ConnexPCB/pcb_piano/README.md

# pcb_piano
PCB with cap touch buttons that activate frequency generator
