ConnexPCB/pcb_piano/pcb_piano/pcb_piano_v1.pdf

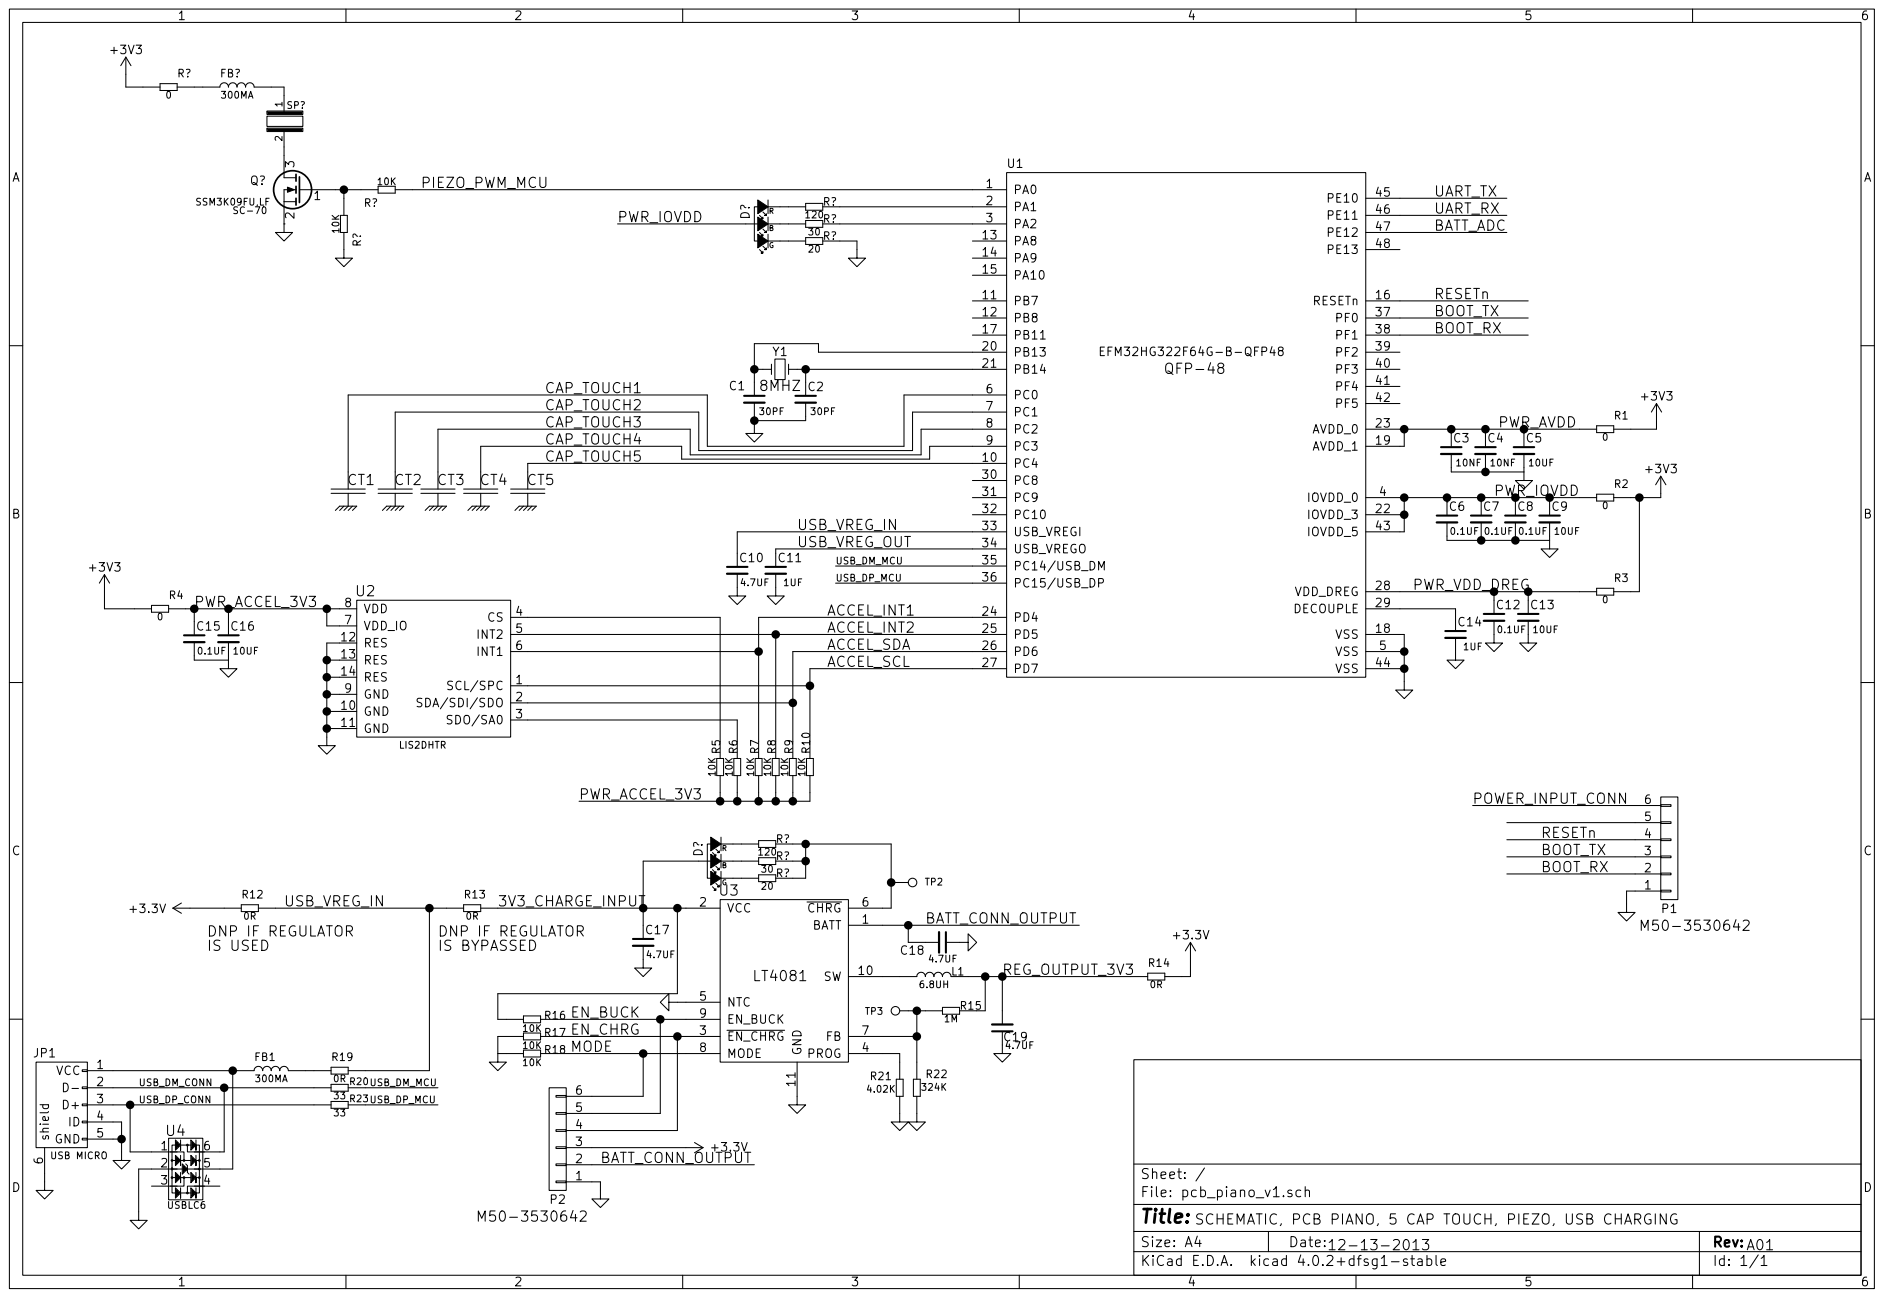
[picture p1: page 1]

CAP_TOUCH2
CAP_TOUCH3
CAP_TOUCH4
CAP_TOUCH5

SCHEMATIC, PCB PIANO, 5 CAP TOUCH, PIEZO, USB CHARGING
