ConnexPCB/pcb_piano/pcb_piano/pcb_piano_v1.kicad_pcb

## KiCad design pcb_piano/pcb_piano_v1.kicad_pcb (2017-12-29)

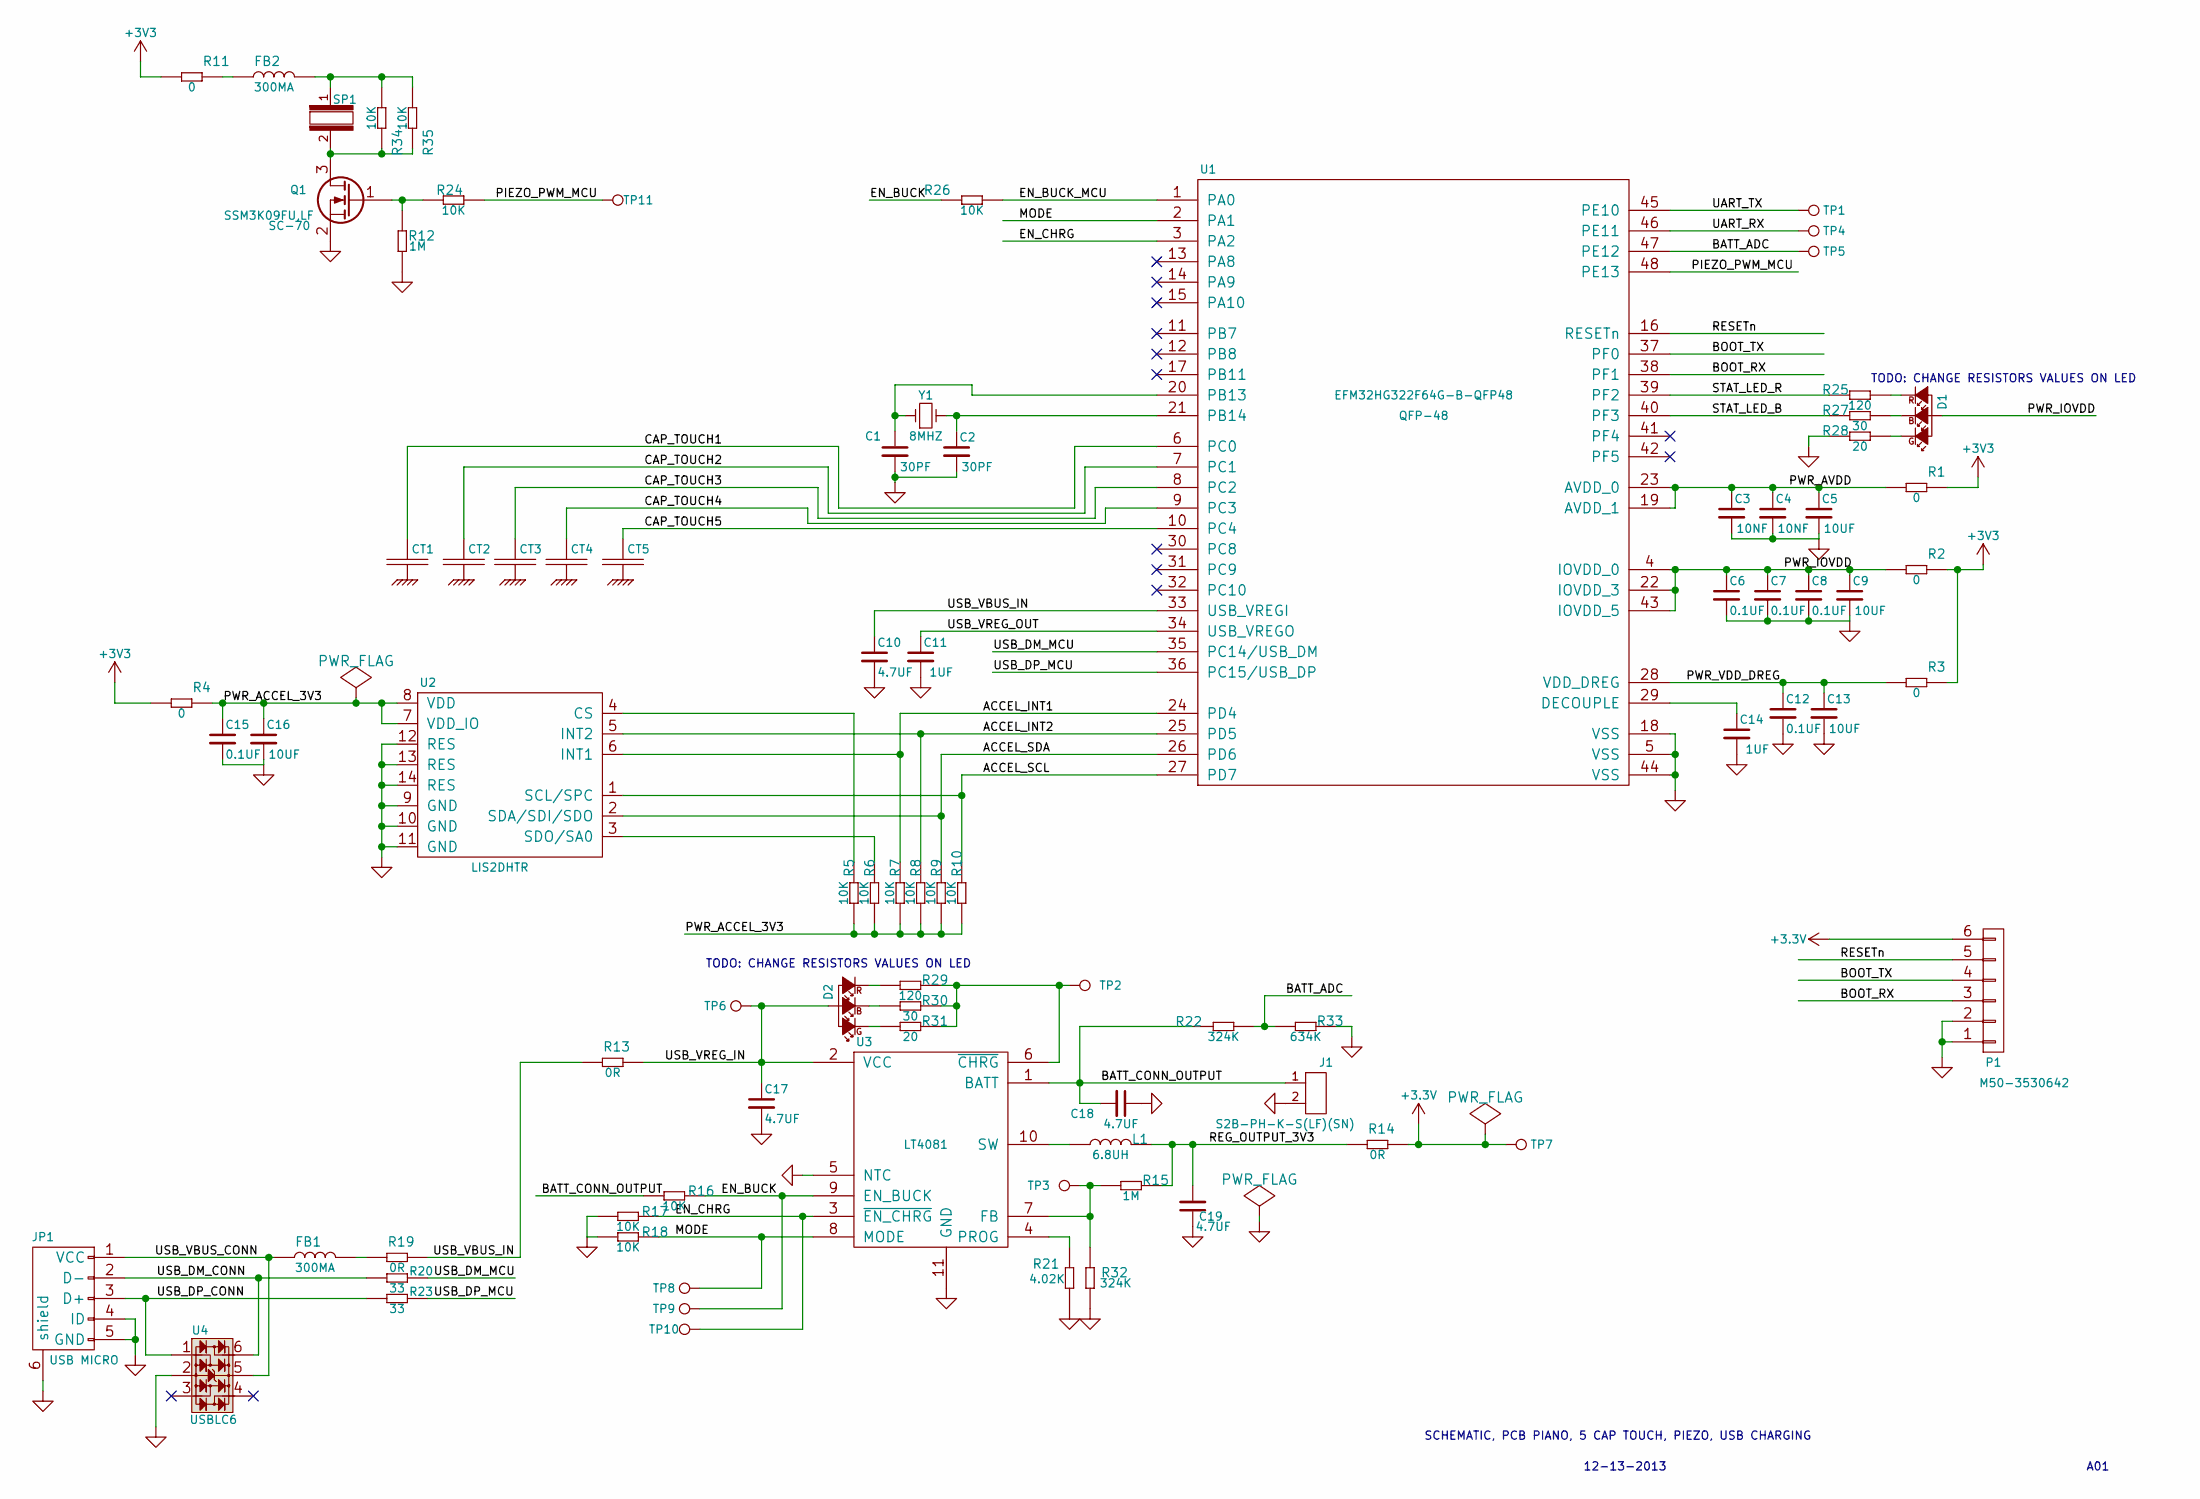
[picture p2: schematic pcb_piano_v1.sch]

Parts:
C1, C2: CONNEX-SMD-CAP-30PF-0402; C_0402; VOLTAGE 25V; MPN GRM1555C1E300JA01D
C3, C4: CONNEX-SMD-CAP-10NF-0402; C_0402; MPN GRM155R71C103KA01D
C5, C9, C13, C16: CONNEX-SMD-CAP-10UF-0402; C_0402; VOLTAGE 6.3V; MPN GRJ155R60J106ME11D
C6, C7, C8, C12, C15: CONNEX-SMD-CAP-100NF-0402; C_0402; MPN GRM155R71E104KE14D
C10, C17, C18, C19: CONNEX-SMD-CAP-4700NF-0603; C_0603; MPN GRM188R60J475ME19D
C11, C14: CONNEX-SMD-CAP-1UF-0402; C_0402; VOLTAGE 35V; MPN GRM155R6YA105KE11J
CT1, CT2, CT3, CT4, CT5: CONNEX-CAPTOUCH-BUTTON-SINGLE; CONNEX-CAPTOUCH-SINGLE-BUTTON-15MM; MPN NA
D1, D2: LED_RGB_SMLP34RGB1W3; led_0404_SMLP34RGB1W3; MPN SMLP34RGB1W3
FB1, FB2: CONNEX-SMD-FERRITE-BEAD-300MA-BLM15AG102SN1D; L_0402; MPN BLM15AG102SN1D
J1: CONNEX_CONN_2PIN_KEYED; CONNEX_CONN-2POS-KEYED-S2B-PH-K-S; MPN S2B-PH-K-S(LF)(SN)
JP1: connex_usb_micro_b_10103594-0001LF; USB_Micro-B_10103594-0001LF; MPN 10118194-0001LF
L1: CONNEX-SMD-INDUCTOR-6R8M-0603; L_0603; MPN GLFR1608T6R8M-LR
P1: CONN_01X06_M50-3530642; Pin_Header_Straight_1x06; MPN M50-3530642
Q1: Q_NMOS_SSM3K09FULF; SC-70; MPN SSM3K09FU,LF
R1, R2, R3, R4, R11: CONNEX-SMD-RES-0-0603; R_0603; MPN CRCW06030000Z0EAHP
R5, R6, R7, R8, R9, R10, R24, R34, R35: CONNEX-SMD-RES-10K-0603; R_0603; MPN CRCW060310K0FKEAHP
R12, R15: CONNEX-SMD-RES-1M-0603; R_0603; MPN RCG06031M00FKEA
R13, R14, R19: SMD-RES-0R-1_4W_0603_; R_0603; MPN CRCW06030000Z0EAHP
R16, R17, R18, R26: SMD-RES-10K-1%-1_10W_0603_; R_0603
R20, R23: CONNEX-SMD-RES-33-0402; R_0402; MPN ERJ-2RKF33R0X
R21: CONNEX-SMD-RES-4K02-0603; R_0603; MPN CRCW06034K02FKEA
R22, R32: CONNEX-SMD-RES-324K-0402; R_0402; MPN RC0402FR-07324KL
R25, R29: CONNEX-SMD-RES-120-0603; R_0603; MPN CRCW0603120RJNEA
R27, R30: CONNEX-SMD-RES-30-0603; R_0603; MPN CRCW060330R0JNEA
R28, R31: CONNEX-SMD-RES-20-0603; R_0603; MPN CRCW060320R0JNEA
R33: CONNEX-SMD-RES-634k-0402; R_0402; MPN ERJ-2RKF6343X
SP1: connex-piezo-4khz-AT-2440-TWT-R; CONNEX-PIEZO-AT-2440-TWT-R; MPN AT-2440-TWT-R
TP1, TP2, TP3, TP4, TP5, TP6, TP7, TP8, TP9, TP10, TP11: test_point_smt; TEST_POINT_SMD_50MIL; MPN na
U1: connex_EFM32HG322F64G-B-QFP48; TQFP-48_7x7mm_Pitch0.5mm; MPN EFM32HG322F64G-B-QFP48
U2: connex-accel-LIS2DHTR; CONNEX_LGA-14_2MMX2MM; MPN LIS2DHTR
U3: CONNEX_REGUL_LT4081; CONNEX_DFN_10PIN_3MMX3MM; MPN LTC4081EDD#PBF
U4: CONNEX-DIODE-TVS-USB-USBLC6-4SC6Y; SOT-23-6; MPN USBLC6-4SC6Y
Y1: Crystal_8MHZ_ABM3B-8.000MHZ-B2-T; CONNEX_CRYSTAL_4SMD_32X50; MPN ABM3B-8.000MHZ-B2-T

Connections:
/ACCEL_INT1: R7.2, U1.24 (PD4), U2.6 (INT1)
/ACCEL_INT2: R8.2, U1.25 (PD5), U2.5 (INT2)
/ACCEL_SCL: R10.2, U1.27 (PD7), U2.1 (SCL/SPC)
/ACCEL_SDA: R9.2, U1.26 (PD6), U2.2 (SDA/SDI/SDO)
/BATT_ADC: R22.1, R33.1, TP5.1, U1.47 (PE12)
/BATT_CONN_OUTPUT: C18.2, J1.1, R16.2, R22.2, U3.1 (BATT)
/BOOT_RX: P1.3, U1.38 (PF1)
/BOOT_TX: P1.4, U1.37 (PF0)
/CAP_TOUCH1: CT1.1, U1.6 (PC0)
/CAP_TOUCH2: CT2.1, U1.7 (PC1)
/CAP_TOUCH3: CT3.1, U1.8 (PC2)
/CAP_TOUCH4: CT4.1, U1.9 (PC3)
/CAP_TOUCH5: CT5.1, U1.10 (PC4)
/EN_BUCK: R16.1, R26.2, TP9.1, U3.9 (EN_BUCK)
/EN_BUCK_MCU: R26.1, U1.1 (PA0)
/EN_CHRG: R17.1, TP10.1, U1.3 (PA2), U3.3 (~EN_CHRG~)
/MODE: R18.1, TP8.1, U1.2 (PA1), U3.8 (MODE)
/PIEZO_PWM_MCU: R24.1, TP11.1, U1.48 (PE13)
/PWR_ACCEL_3V3: C15.1, C16.1, R4.2, R5.1, R6.1, R7.1, R8.1, R9.1, R10.1, U2.7 (VDD_IO), U2.8 (VDD)
/PWR_AVDD: C3.1, C4.1, C5.1, R1.1, U1.19 (AVDD_1), U1.23 (AVDD_0)
/PWR_IOVDD: C6.1, C7.1, C8.1, C9.1, D1.1, R2.1, U1.4 (IOVDD_0), U1.22 (IOVDD_3), U1.43 (IOVDD_5)
/PWR_VDD_DREG: C12.1, C13.1, R3.1, U1.28 (VDD_DREG)
/REG_OUTPUT_3V3: C19.2, L1.2, R14.1, R15.2
/RESETn: P1.5, U1.16 (RESETn)
/STAT_LED_B: R27.2, U1.40 (PF3)
/STAT_LED_R: R25.2, U1.39 (PF2)
/UART_RX: TP4.1, U1.46 (PE11)
/UART_TX: TP1.1, U1.45 (PE10)
/USB_DM_CONN: JP1.2 (D-), R20.1, U4.6 (IO4)
/USB_DM_MCU: R20.2, U1.35 (PC14/USB_DM)
/USB_DP_CONN: JP1.3 (D+), R23.1, U4.1 (IO1)
/USB_DP_MCU: R23.2, U1.36 (PC15/USB_DP)
/USB_VBUS_CONN: FB1.1, JP1.1 (VCC), U4.5 (VBUS)
/USB_VBUS_IN: C10.1, R13.1, R19.2, U1.33 (USB_VREGI)
/USB_VREG_IN: C17.1, D2.1, R13.2, TP6.1, U3.2 (VCC)
/USB_VREG_OUT: C11.1, U1.34 (USB_VREGO)
GND: C1.2, C2.2, C3.2, C4.2, C5.2, C6.2, C7.2, C8.2, C9.2, C10.2, C11.2, C12.2, C13.2, C14.2, C15.2, C16.2, C17.2, C18.1, C19.1, J1.2, JP1.4 (ID), JP1.5 (GND), JP1.6 (shield), P1.1, P1.2, Q1.2 (S), R12.2, R17.2, R18.2, R21.1, R28.2, R32.2, R33.2, U1.5 (VSS), U1.18 (VSS), U1.44 (VSS), U2.9 (GND), U2.10 (GND), U2.11 (GND), U2.12 (RES), U2.13 (RES), U2.14 (RES), U3.5 (NTC), U3.11 (GND), U4.2 (GND)
unnamed: C1.1, U1.20 (PB13), Y1.1
unnamed: C2.1, U1.21 (PB14), Y1.3
unnamed: C14.1, U1.29 (DECOUPLE)
unnamed: D1.2 (R), R25.1
unnamed: D1.3 (B), R27.1
unnamed: D1.4 (G), R28.1
unnamed: D2.2 (R), R29.1
unnamed: D2.3 (B), R30.1
unnamed: D2.4 (G), R31.1
unnamed: FB1.2, R19.1
unnamed: FB2.1, R11.2
unnamed: FB2.2, R34.1, R35.1, SP1.1
unnamed: L1.1, U3.10 (SW)
unnamed: Q1.1 (G), R12.1, R24.2
unnamed: Q1.3 (D), R34.2, R35.2, SP1.2
unnamed: R5.2, U2.4 (CS)
unnamed: R6.2, U2.3 (SDO/SA0)
unnamed: R15.1, R32.1, TP3.1, U3.7 (FB)
unnamed: R21.2, U3.4 (PROG)
unnamed: R29.2, R30.2, R31.2, TP2.1, U3.6 (~CHRG~)

Notes on the sheet:
SCHEMATIC, PCB PIANO, 5 CAP TOUCH, PIEZO, USB CHARGING
12-13-2013
A01
TODO: CHANGE RESISTORS VALUES ON LED

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
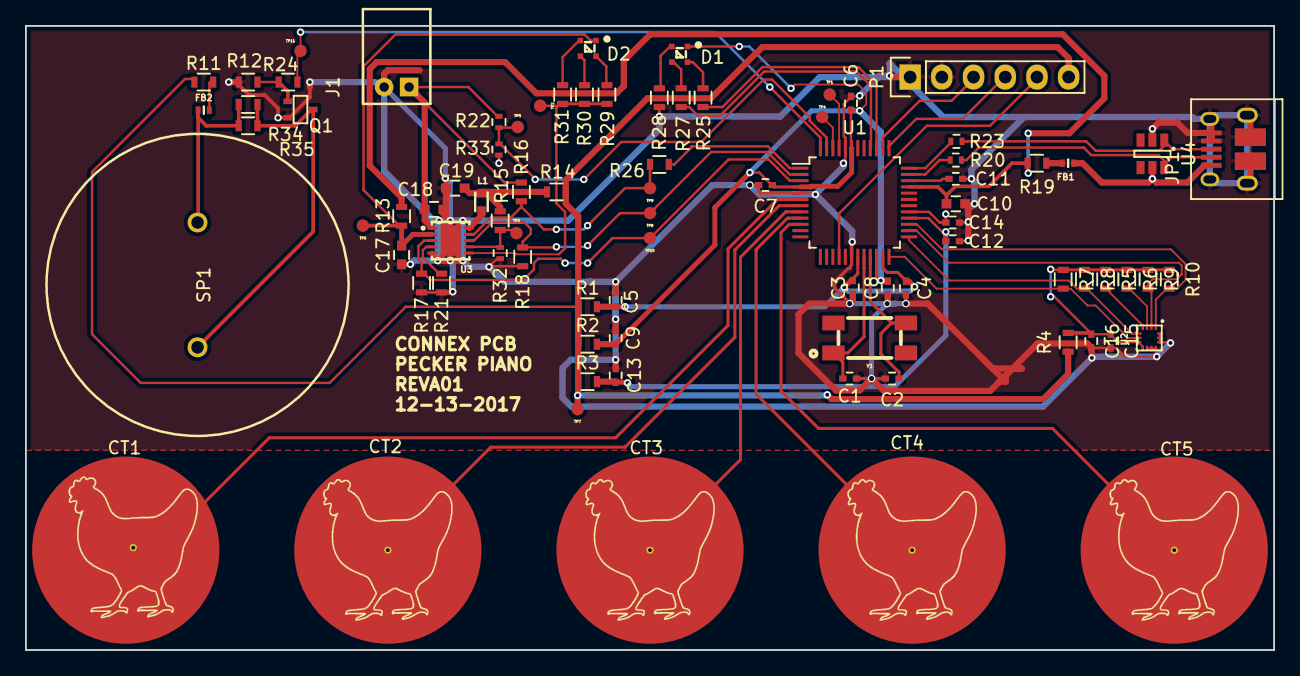
[picture p3: board pcb_piano_v1.kicad_pcb from above]

Board: 2 copper layers, 100.0 x 50.0 mm, 85 parts (0 on the bottom side), 58 nets.
