ConnexPCB/pcb_piano/sw_piano/testFirmware/src/sinTable.cpp

/*
 * sinTable.c
 *
 *  Created on: Jan 2, 2018
 *      Author: birdman
 */

#include "sinTable.h"


 static const uint32_t sineTableLength = NUM_SINE_SAMPLES;
//  static const uint16_t sineTable[NUM_SINE_SAMPLES] =
//  {
// 375,	375,	376,	376,	377,	377,	378,	379,	379,	380,	380,	381,	381,	382,	383,	383,	384,	384,	385,	385,	386,	387,	387,	388,	388,	389,	389,	390,	391,	391,	392,	392,
// 393,	393,	394,	395,	395,	396,	396,	397,	397,	398,	399,	399,	400,	400,	401,	402,	402,	403,	403,	404,	404,	405,	406,	406,	407,	407,	408,	408,	409,	410,	410,	411,
// 411,	412,	412,	413,	414,	414,	415,	415,	416,	416,	417,	418,	418,	419,	419,	420,	420,	421,	422,	422,	423,	423,	424,	424,	425,	426,	426,	427,	427,	428,	428,	429,
// 430,	430,	431,	431,	432,	432,	433,	434,	434,	435,	435,	436,	436,	437,	437,	438,	439,	439,	440,	440,	441,	441,	442,	443,	443,	444,	444,	445,	445,	446,	447,	447,
// 448,	448,	449,	449,	450,	450,	451,	452,	452,	453,	453,	454,	454,	455,	456,	456,	457,	457,	458,	458,	459,	459,	460,	461,	461,	462,	462,	463,	463,	464,	465,	465,
// 466,	466,	467,	467,	468,	468,	469,	470,	470,	471,	471,	472,	472,	473,	473,	474,	475,	475,	476,	476,	477,	477,	478,	478,	479,	479,	480,	481,	481,	482,	482,	483,
// 483,	484,	484,	485,	486,	486,	487,	487,	488,	488,	489,	489,	490,	490,	491,	492,	492,	493,	493,	494,	494,	495,	495,	496,	496,	497,	498,	498,	499,	499,	500,	500,
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
//		134,	134,	134,	134,	134,	134,	134,	134,	134,	134,	134,	134,	134,	134,	134,	134,	134,	134,	134,	134,	134,	134,	134,	134,	134,	134,	135,	135,	135,	135,	135,	135,
//		135,	135,	135,	135,	135,	135,	135,	135,	135,	135,	135,	135,	135,	135,	135,	135,	135,	135,	135,	135,	135,	135,	135,	136,	136,	136,	136,	136,	136,	136,	136,	136,
//		136,	136,	136,	136,	136,	136,	136,	136,	136,	136,	136,	136,	136,	136,	136,	136,	136,	136,	136,	136,	136,	137,	137,	137,	137,	137,	137,	137,	137,	137,	137,	137,
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
//};

 uint16_t returnSinIndex(uint32_t index)
 {
 	return sineTable[index];
 }

 uint32_t returnSinSize(void)
 {
 	return sineTableLength;
 }
