ConnexPCB/pcb_piano/(commit log)

2017-12-12 Created kicad project for pcb_piano. Added connexPCB_libs submodule.
    [pcb_piano_v1.kicad_pcb, pcb_piano_v1.sch]
2017-12-13 Progress on schematic. Added happy gecko, regulator, and cap touch
    [pcb_piano_v1.sch]
2017-12-14 Added usb charging, ferrite bead, and piezo, began layout
    [pcb_piano_v1.kicad_pcb, pcb_piano_v1.sch]
2017-12-29 Pushed Version 1 hardware
    [pcb_piano_v1.kicad_pcb, pcb_piano_v1.sch]
2018-01-07 Mostly functional circular buffer with pwm. Though still has issues....
    [circBuffer.h, debugUart.c, debugUart.h, main.c, pianoTimer.h, sinTable.h, util.h]
2018-01-13 Updated git ignore to be C and KiCAD
2018-01-13 Working version with PWM using DMA
2018-01-14 Note initialization to use sinusoid, and autoconfigure frequency based on PWM frequency (20khz)
2018-01-15 Working version with single button captouch using PRS and Timers to monitor in background
2018-01-15 Hacked together multitouch buttons
2018-01-27 Working version. Frequency calculation changed to be based on number of samples between 8 and 20 for 40kHz. Added top value to dutyCycle calculation (525) to prevent dutyCycle to be greater than top
    [circBuffer.h, debugUart.cpp, dmaPwm.cpp, dmaPwm.h, main.cpp, pianoTimer.cpp, pianoTimer.h, sinTable.cpp]
2018-01-28 Non-working first conversion of leuart to dma
